remrc/Two-Axis-Reaction-Wheel-Stick/schematic.pdf

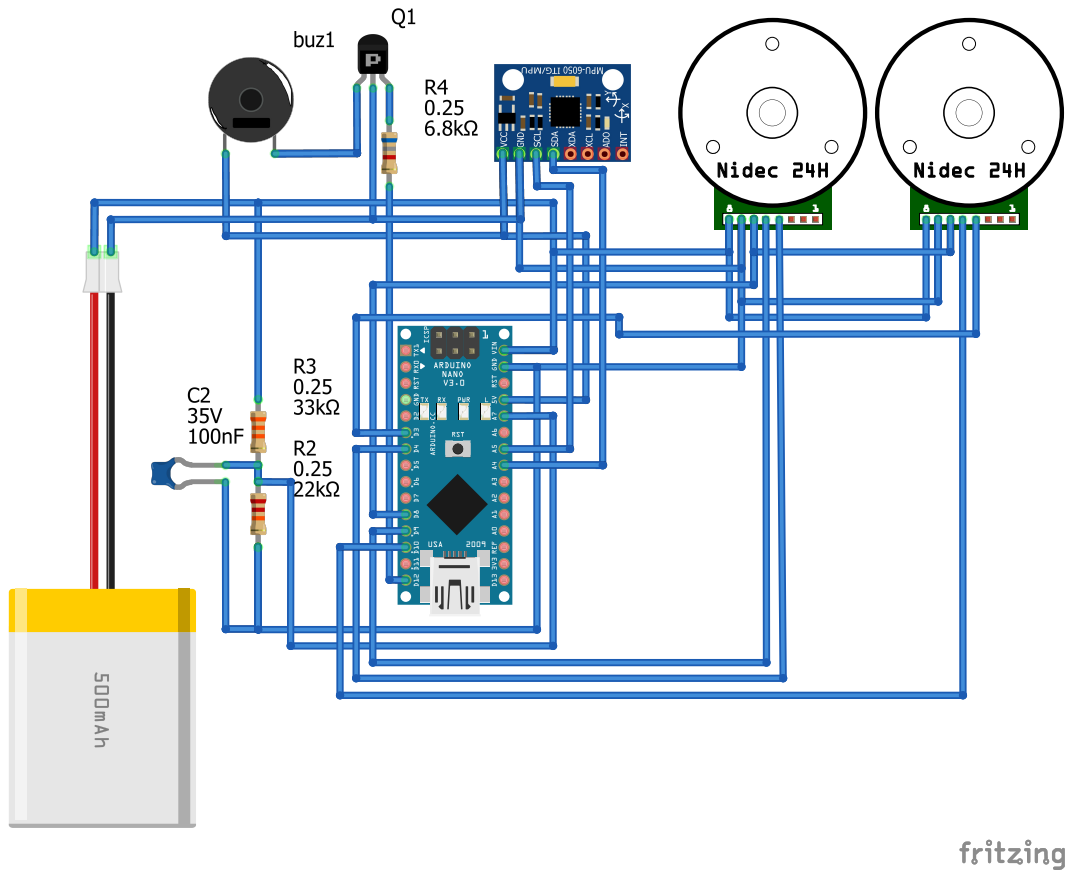
[picture p4: page 1]
