remrc/Two-Axis-Reaction-Wheel-Stick/(threads)

Thread 1 (2022-08-15):

Relationship between height and wheel diameter and overall weight

vongomben, 2022-08-15:
Wonderful project. Have some questions:

1) How tall can it reach?
2) IS there any relationship with the width of the wheels and the height of the overall stick?
3) how could the wheels be more little? maybe multiplying them?
4) Is there a relationship between the overall weight of the stick and the width of the wheels?

remrc, 2022-08-15:
You can watch another videos.  There is a bit about what depends on what.

vongomben, 2022-08-16:
Ok I'm checking all te other videos.
Can you be more precised though?

thanks in advance

remrc, 2022-08-16:
1. depends on motors, wheels weight
2. yes
3. more powerful motors, bigger wheels
4. yes, the greater the total weight, the larger (heavier) the wheels should be. It also means more powerful motors

Closed 2023-10-27.

Thread 2 (2022-08-15):

BT Documentations

vongomben, 2022-08-15:
Hi
From [this video](https://www.youtube.com/watch?v=vXHlW2S24GQ) I've seen a BT module.
I assume [this is ](https://github.com/remrc/Two-Axis-Reaction-Wheel-Stick/blob/main/functions.ino#L108) the sofwtare serial code receiving the data.
Which app are you uding to control the device?

best

remrc, 2022-08-15:
I use the BT module to adjust the parameters. I send commands only from the serial terminal.

Closed 2023-10-27.

Thread 4 (2023-10-26):

What PWM Library are you using?

djdenholm, 2023-10-26:
Do you have a recommended PWM.h file to use?

remrc, 2023-10-26:
As far as I remember, this is an built in Arduino PWM library.

djdenholm, 2023-10-31:
I used this library: https://github.com/terryjmyers/PWM

Closed 2023-10-31.

Thread 5 (2023-10-27):

Calibration issues

djdenholm, 2023-10-27:
I continue to get the following and can't seem to track down why.
X: 20.38 Y: -7.51
The angles are wrong!!!

It doesnt matter what orientation i have the MPU in.

remrc, 2023-10-27:
MPU position is important! And only as shown in my video.

djdenholm, 2023-10-30:
I found out that the batch of MPU6050s i had bought were bad. SO the cal issues fixed with new MPUs.

That being said, I only have 1 motor responding and i am not getting any buzzer noises at all.

remrc, 2023-10-30:
I have never seen a bad MPU6050. Although I has more than one of them.
Only one motor works? Look for mistakes in connections.

djdenholm, 2023-10-31:
For the motors, I figured it out when i swap the wiring harnesses. The same motor works regardless of which harness is hooked up.

For Part Q1 is that a 2N2222 transistor?

remrc, 2023-10-31:
You can use 2N2222. But I use another. So, you need to check the transistor pinout.

Aron-1381, 2025-07-13:
hi remrc, excellent job to do these all wonderful balancing robots!

Thread 6 (2025-06-26):

schematic issues

waxwing420, 2025-06-26:
Hiya! I've been trying to make this for months and i've finally got everything i need. Everything except one thing.. on the schematic, what is that black thing with a P labelled Q1?

waxwing420, 2025-07-05:
is it possible to get the whole schematic like that? i've soldered 3 boards together each following the schematic you provided but i cannot get it working at all.. the buzzer just beeps constantly and the serial monitor just says "calibrating gyroscope" and nothing else. Sending the C+ and C- commands do nothing at all.

remrc, 2025-07-05:
No, it's not for beginners. It doesn't require a lot of knowledge. But if you do it without thinking, it won't work.

Closed 2025-07-05.
